Daft-Freak/py32-i2c-gamepad/hw/py32-gamepad.kicad_pcb

## KiCad design hw/py32-gamepad.kicad_pcb (2025-01-22)

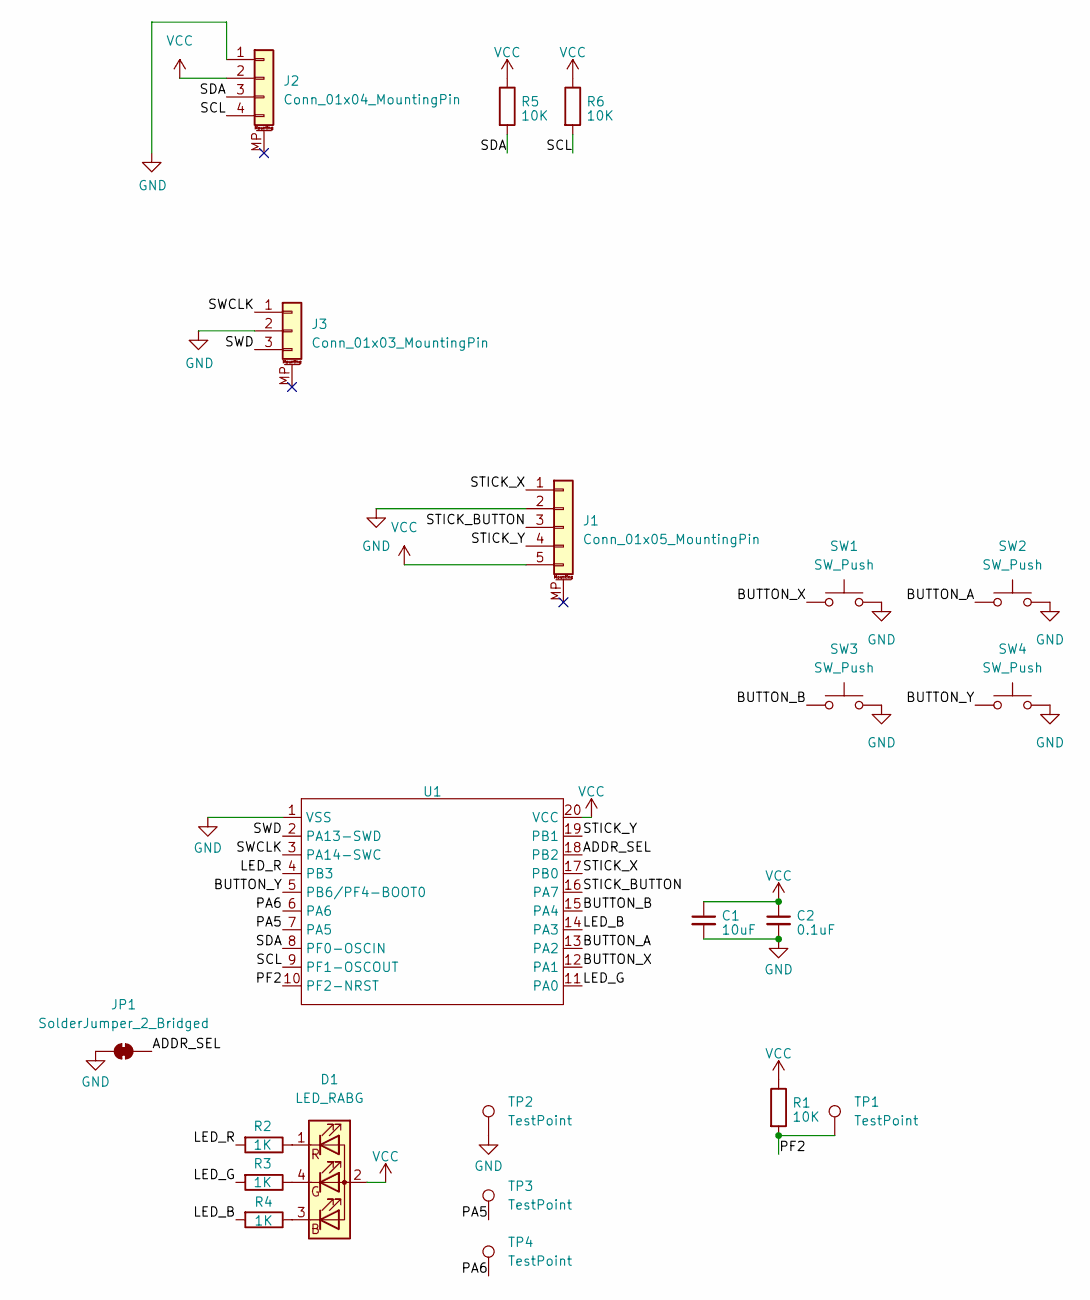
[picture p1: schematic py32-gamepad.kicad_sch]

Parts:
C1: 10uF; C_0603_1608Metric
C2: 0.1uF; C_0402_1005Metric
D1: LED_RABG; LED_0606
J1: Conn_01x05_MountingPin; HCTL_HC-FPC-05-09-5RLTAG-00_1x05-1MP_P0.50mm_Horizontal
J2: Conn_01x04_MountingPin; JST_SH_SM04B-SRSS-TB_1x04-1MP_P1.00mm_Horizontal
J3: Conn_01x03_MountingPin; JST_SH_SM03B-SRSS-TB_1x03-1MP_P1.00mm_Horizontal
JP1: SolderJumper_2_Bridged; SolderJumper-2_P1.3mm_Bridged_RoundedPad1.0x1.5mm
R1, R5, R6: 10K; R_0402_1005Metric
R2, R3, R4: 1K; R_0402_1005Metric
SW1, SW2, SW3, SW4: SW_Push; SW_Push_1P1T_NO_GT-TC155x
TP1, TP2, TP3, TP4: TestPoint; TestPoint_Pad_1.0x1.0mm
U1: TSSOP-20_4.4x6.5mm_P0.65mm

Connections:
/ADDR_SEL: JP1.2 (B), U1.18 (PB2)
/BUTTON_A: SW2.1, U1.13 (PA2)
/BUTTON_B: SW3.1, U1.15 (PA4)
/BUTTON_X: SW1.1, U1.12 (PA1)
/BUTTON_Y: SW4.1, U1.5 (PB6/PF4-BOOT0)
/LED_B: R4.2, U1.14 (PA3)
/LED_G: R3.2, U1.11 (PA0)
/LED_R: R2.2, U1.4 (PB3)
/PA5: TP3.1, U1.7 (PA5)
/PA6: TP4.1, U1.6 (PA6)
/PF2: R1.2, TP1.1, U1.10 (PF2-NRST)
/SCL: J2.4, R6.2, U1.9 (PF1-OSCOUT)
/SDA: J2.3, R5.2, U1.8 (PF0-OSCIN)
/STICK_BUTTON: J1.3, U1.16 (PA7)
/STICK_X: J1.1, U1.17 (PB0)
/STICK_Y: J1.4, U1.19 (PB1)
/SWCLK: J3.1, U1.3 (PA14-SWC)
/SWD: J3.3, U1.2 (PA13-SWD)
GND: C1.2, C2.2, J1.2, J2.1, J3.2, JP1.1 (A), SW1.2, SW2.2, SW3.2, SW4.2, TP2.1, U1.1 (VSS)
unnamed: D1.3 (BK), R4.1
unnamed: D1.4 (GK), R3.1
unnamed: D1.1 (RK), R2.1
VCC: C1.1, C2.1, D1.2 (A), J1.5, J2.2, R1.1, R5.1, R6.1, U1.20 (VCC)

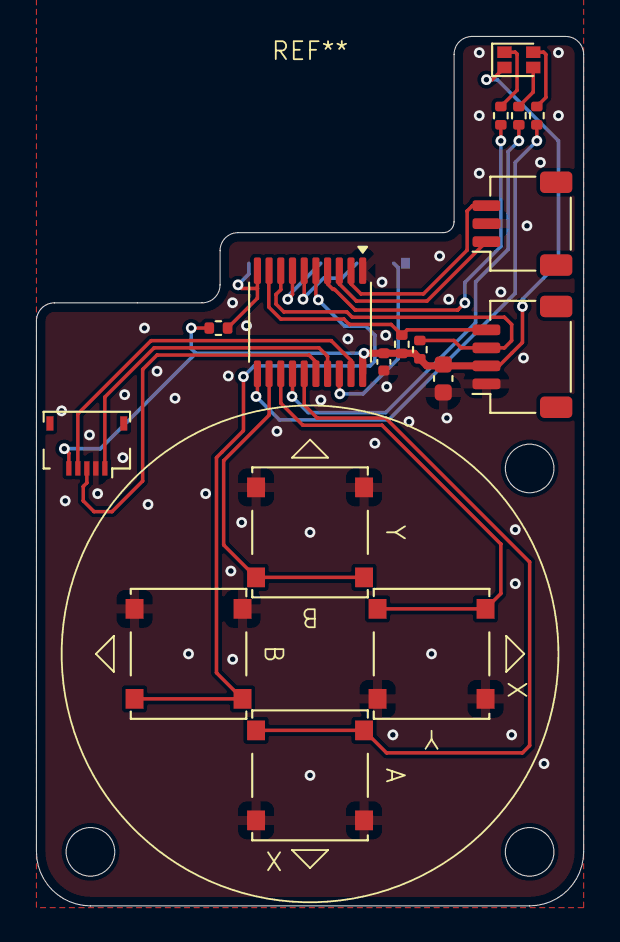
[picture p2: board py32-gamepad.kicad_pcb from above]

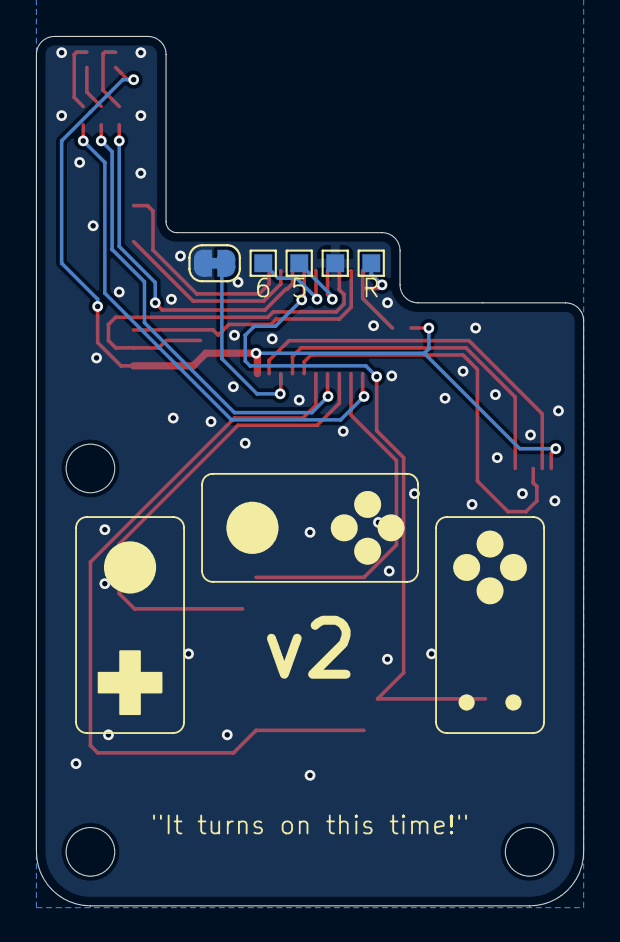
[picture p3: board py32-gamepad.kicad_pcb from below]

Board: 2 copper layers, 30.4 x 48.3 mm, 22 parts (5 on the bottom side), 23 nets.
