Daft-Freak/py32-i2c-gamepad/(commit log)

2024-11-14 Initial CMake setup
    It compiles, but we're missing the startup code. startup and linker script taken from https://github.com/IOsetting/py32f0-template
    [main.cpp]
2024-11-14 Import minimal ARM CMSIS headers
    https://github.com/ARM-software/CMSIS_6 v6.1.0
2024-11-14 Setup clocks and test uart
2024-11-15 uart printf helper
2024-11-15 ADC setup
2024-11-15 Less adc printing
2024-11-16 I2C slave setup
    Okay, that's the basic idea working!
2024-12-17 Update for PCB
    Mostly disabling UART and pulling up a few more pins
2024-12-17 Some initial LED PWM
    Because of board mistakes we only have PWM on G, and no R at all
    [main.cpp]
2024-12-19 Enable ADC interrupt and WFE while reading
2024-12-19 I2C address config
2024-12-19 Partial red LED hack on PA5
2024-12-19 gpio.h fixes for C
    [gpio.h]
2024-12-19 Refactor UART helpers out of main
2024-12-19 LED gamma correction
    Throwing some numbers at it
    [main.cpp]
2024-12-20 Add 16 bytes of I2C writable data
    Should be more than enough
2024-12-20 Control LED from I2C data
2025-01-22 Add board kicad project
    V2/the working version
    [py32-gamepad.kicad_pcb, py32-gamepad.kicad_sch]
2025-01-22 Write calibration to the end of flash
2025-01-22 Fix ADC clamping
2025-01-30 Rework I2C a bit and handle bus errors
    This doesn't fully fix the reset problems but does improve it a lot
    [main.cpp]
